Remus287/Hydrophone/Top_Sheet_Diagram.png

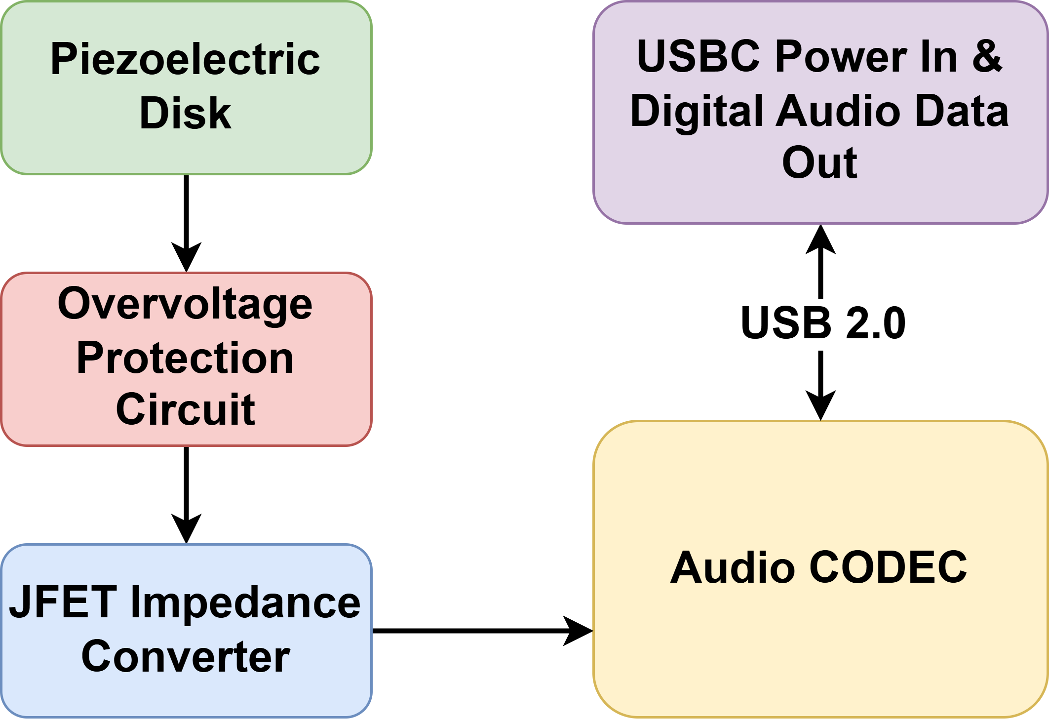
Top_Sheet_Diagram.png
