Remus287/Hydrophone/ul_OPA1642AIDR/D0008A.stp

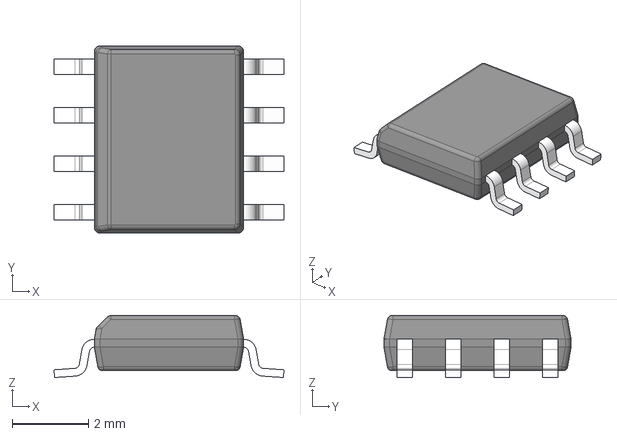
[picture p2: CAD file, 2025-02-16]
ul_OPA1642AIDR/D0008A.stp
6.02 x 4.90 x 1.63 mm
BODY-SO
LEAD-D0008A x 8
