Remus287/Hydrophone/ul_PCM2912APJTR/PJT0032A.stp

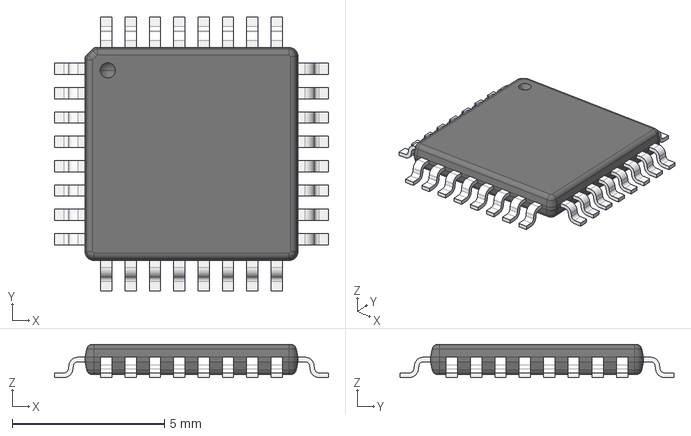
[picture p3: CAD file, 2025-02-16]
ul_PCM2912APJTR/PJT0032A.stp
9.00 x 9.00 x 1.10 mm
LEAD-QFP x 32
