Remus287/Hydrophone/Hydrophone.kicad_pcb

## KiCad design Hydrophone.kicad_pcb (2025-02-17)

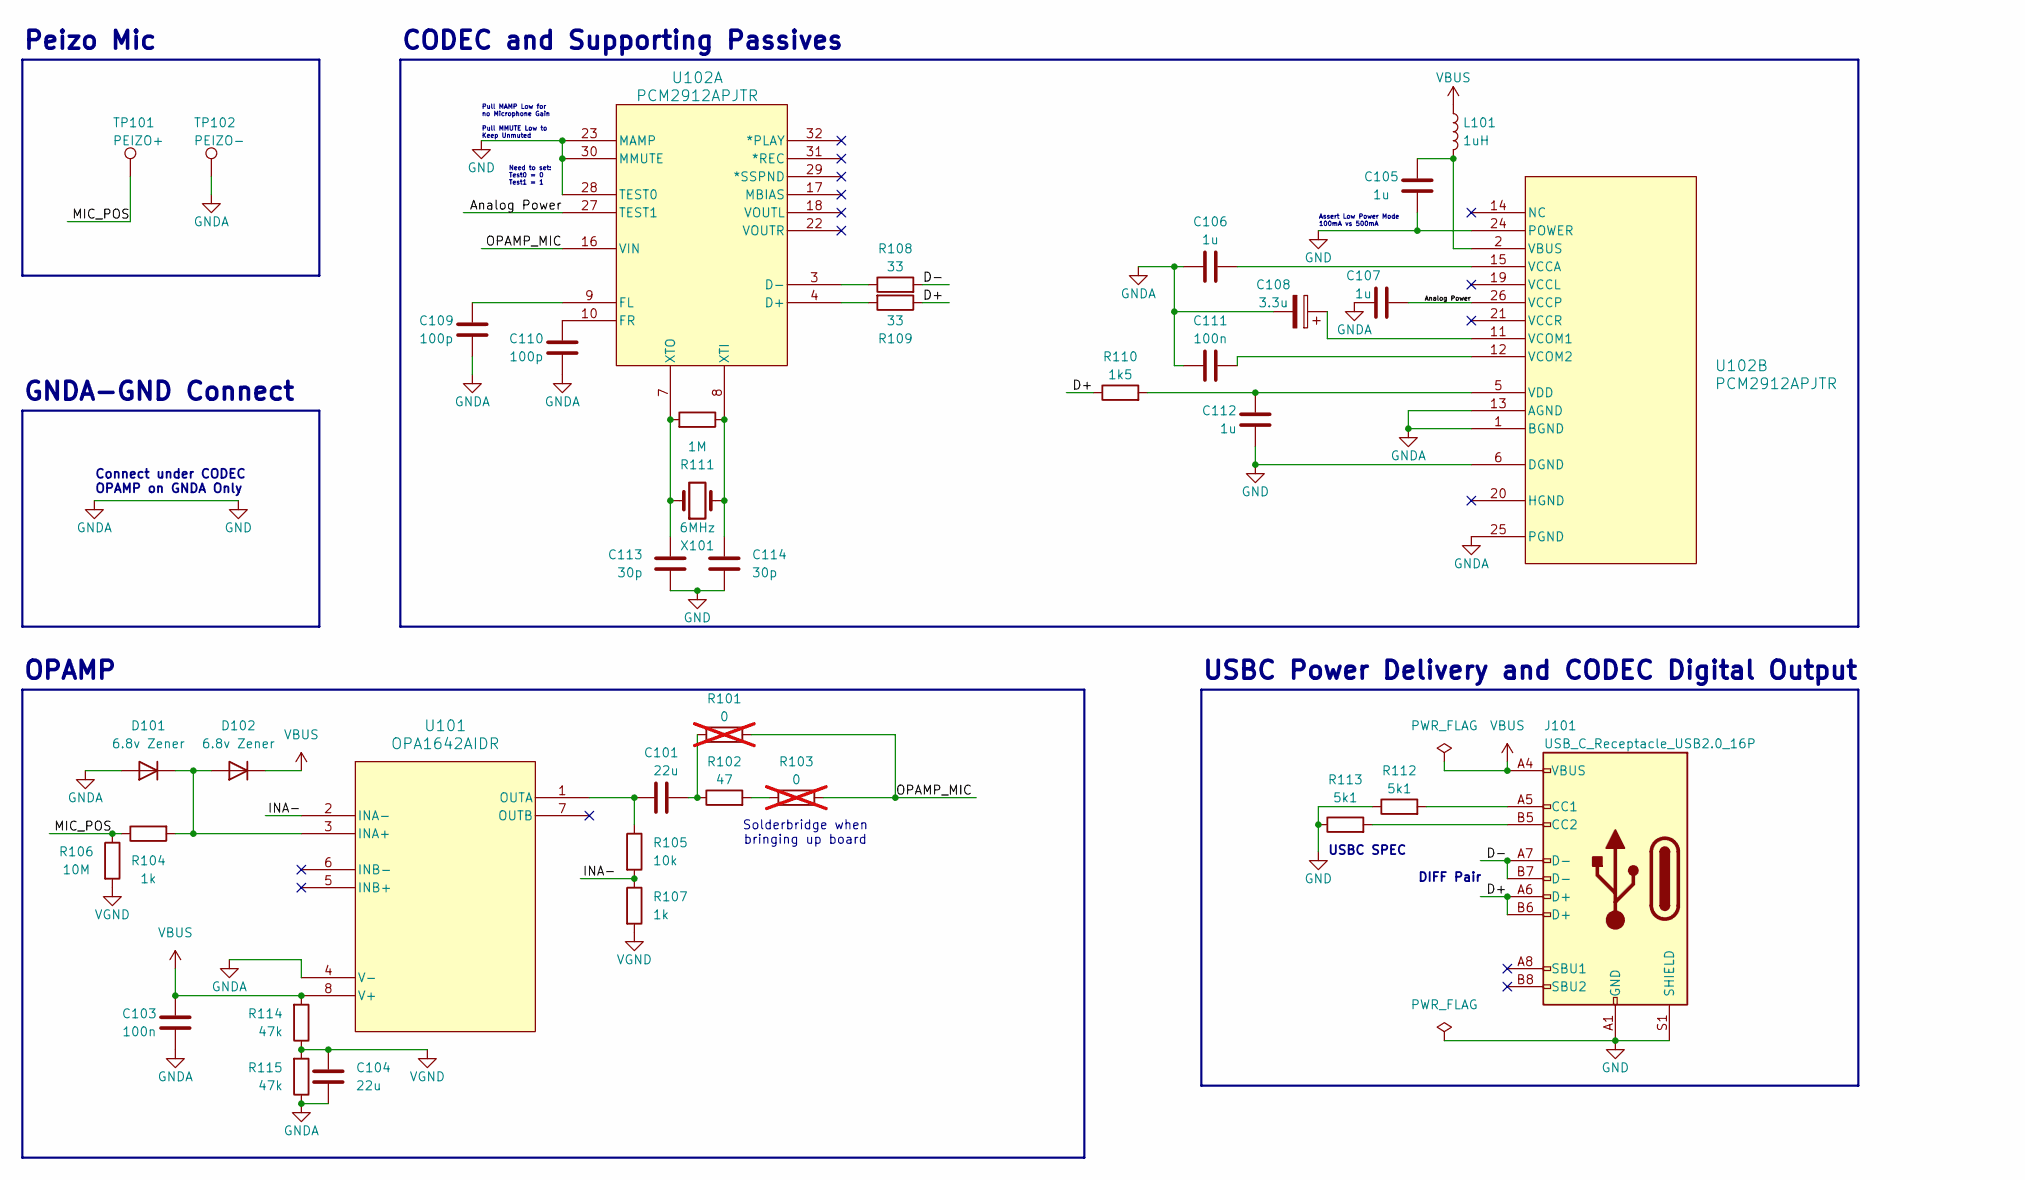
[picture p4: schematic USBC_Out.kicad_sch, Hydrophone]

Parts:
C101, C104: 22u; C_0805_2012Metric; Part Number CL21A226MAQNNNE; JLCPCB Part# C45783
C103, C111: 100n; C_0402_1005Metric; Part Number CL05B104KO5NNNC; JLCPCB Part# C1525
C105, C106, C107, C112: 1u; C_0402_1005Metric; Part Number CL05A105KA5NQNC; JLCPCB Part# C52923
C108: 3.3u; CP_EIA-3216-18_Kemet-A; Part Number TAJA335K016RNJ; JLCPCB Part# C7184
C109, C110: 100p; C_0402_1005Metric; Part Number 0402CG101J500NT; JLCPCB Part# C1546
C113, C114: 30p; C_0402_1005Metric; Part Number 0402CG300J500NT; JLCPCB Part# C1570
D101, D102: 6.8v Zener; D_SOD-123; Part Number BZT52C6V8; JLCPCB Part# C2120
J101: USB_C_Receptacle_USB2.0_16P; USB_C_Receptacle_G-Switch_GT-USB-7025; Part Number GT-USB-7025; JLCPCB Part# C963213
L101: 1uH; L_1210_3225Metric; Part Number NLV32T-1R0J-PF; JLCPCB Part# C22202
R101, R103: 0; R_0603_1608Metric; not fitted
R102: 47; R_0805_2012Metric; Part Number 1206W4F1002T5E; JLCPCB Part# C17902
R104, R107: 1k; C_0402_1005Metric; Part Number 0402WGF1001TCE; JLCPCB Part# C11702
R105: 10k; R_1206_3216Metric; Part Number 1206W4F1002T5E; JLCPCB Part# C17902
R106: 10M; R_0402_1005Metric; Part Number 0402WGF1005TCE; JLCPCB Part# C26082
R108, R109: 33; R_0402_1005Metric; Part Number 0402WGF330JTCE; JLCPCB Part# C25105
R110: 1k5; R_0402_1005Metric; Part Number 0402WGJ0152TCE; JLCPCB Part# C25930
R111: 1M; R_0402_1005Metric; Part Number 0402WGF1004TCE; JLCPCB Part# C26083
R112, R113: 5k1; R_0402_1005Metric; Part Number 0402WGF5101TCE; JLCPCB Part# C25905
R114, R115: 47k; R_0402_1005Metric; Part Number 0402WGF4702TCE; JLCPCB Part# C25792
TP101: PEIZO+; TestPoint_Pad_D1.0mm; Part Number ---
TP102: PEIZO-; TestPoint_Pad_D1.0mm; Part Number ---
U101: OPA1642AIDR; D8; Part Number OPA1642AIDR; JLCPCB Part# C67640
U102: PCM2912APJTR; PJT32; Part Number PCM2912APJTR; JLCPCB Part# C475497
X101: 6MHz; Crystal_SMD_HC49-SD; Part Number H6OEL89CSC-SUGYLC-6M; JLCPCB Part# C7528811

Connections:
/USBC_Out/Analog Power: C107.1, U102.26 (VCCP), U102.27 (TEST1)
/USBC_Out/D+: J101.A6 (D+), J101.B6 (D+), R109.1, R110.1
/USBC_Out/D-: J101.A7 (D-), J101.B7 (D-), R108.2
/USBC_Out/INA-: R105.2, R107.1, U101.2 (INA-)
/USBC_Out/MIC_POS: R104.1, R106.1, TP101.1
/USBC_Out/OPAMP_MIC: R101.2, R103.2, U102.16 (VIN)
GND: C103.2, C104.2, C105.2, C106.2, C107.2, C108.2, C109.2, C110.2, C111.2, C112.1, C113.2, C114.2, D101.2 (A), J101.A1 (GND), J101.A12 (GND), J101.B1 (GND), J101.B12 (GND), J101.S1 (SHIELD), R112.1, R113.1, R115.1, TP102.1, U101.4 (V-), U102.1 (BGND), U102.6 (DGND), U102.13 (AGND), U102.23 (MAMP), U102.24 (POWER), U102.25 (PGND), U102.28 (TEST0), U102.30 (MMUTE)
unnamed: C101.1, R101.1, R102.1
unnamed: D101.1 (K), D102.2 (A), R104.2, U101.3 (INA+)
unnamed: J101.A5 (CC1), R112.2
unnamed: J101.B5 (CC2), R113.2
unnamed: R102.2, R103.1
unnamed: C101.2, R105.1, U101.1 (OUTA)
unnamed: R109.2, U102.4 (D+)
unnamed: R108.1, U102.3 (D-)
unnamed: C109.1, U102.9 (FL)
unnamed: C110.1, U102.10 (FR)
unnamed: C114.1, R111.1, U102.8 (XTI), X101.2
unnamed: C113.1, R111.2, U102.7 (XTO), X101.1
unnamed: C105.1, L101.2, U102.2 (VBUS)
unnamed: C106.1, U102.15 (VCCA)
unnamed: C108.1, U102.11 (VCOM1)
unnamed: C111.1, U102.12 (VCOM2)
unnamed: C112.2, R110.2, U102.5 (VDD)
VBUS: C103.1, D102.1 (K), J101.A4 (VBUS), J101.A9 (VBUS), J101.B4 (VBUS), J101.B9 (VBUS), L101.1, R114.2, U101.8 (V+)
VGND: C104.1, R106.2, R107.2, R114.1, R115.2

Notes on the sheet:
DIFF Pair
Need to set: Test0 = 0 Test1 = 1
USBC Power Delivery and CODEC Digital Output
Assert Low Power Mode 100mA vs 500mA
USBC SPEC
CODEC and Supporting Passives
Connect under CODEC OPAMP on GNDA Only
Solderbridge when bringing up board
Peizo Mic
Pull MAMP Low for no Microphone Gain Pull MMUTE Low to Keep Unmuted
OPAMP
GNDA-GND Connect

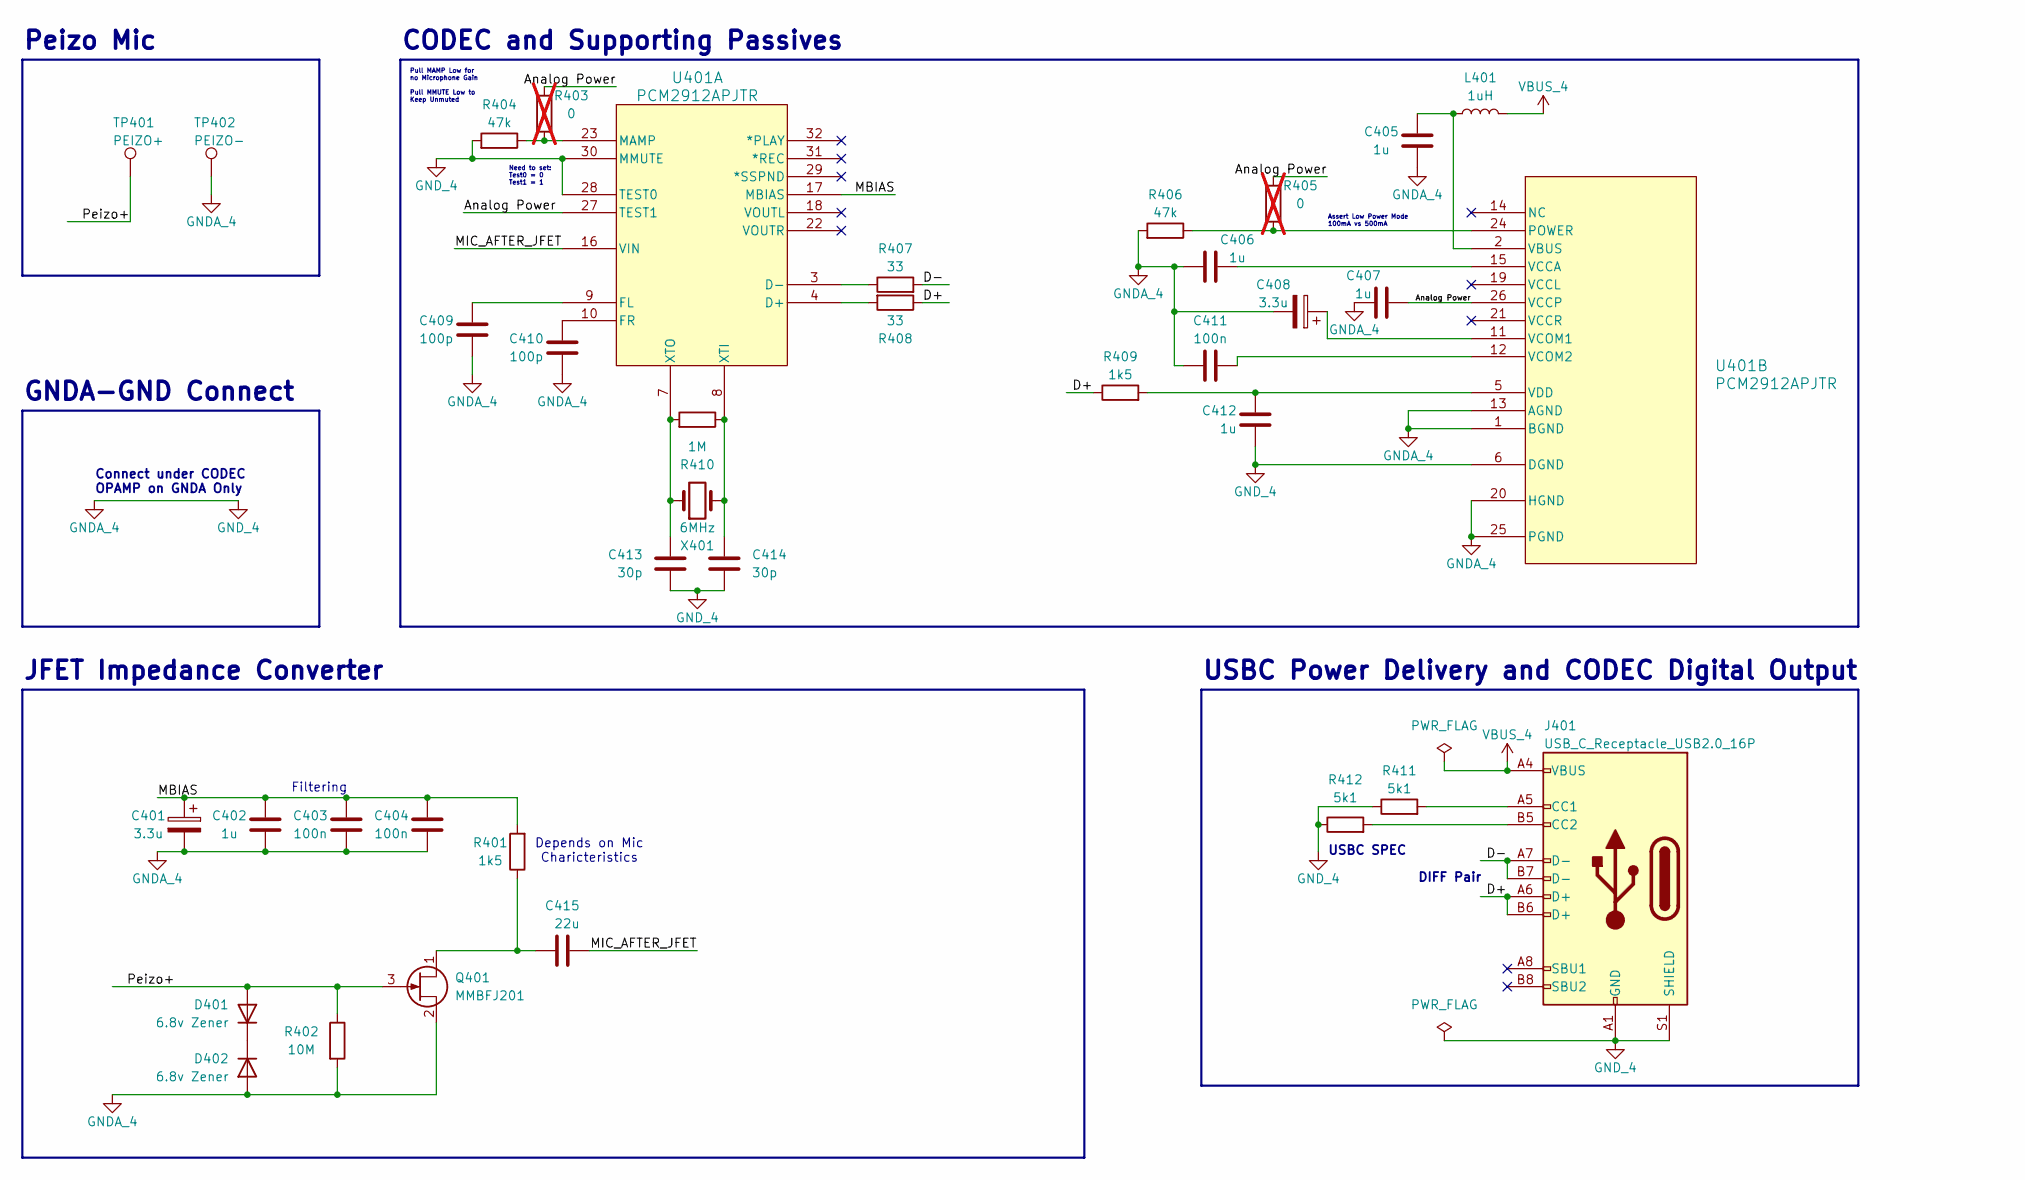
[picture p5: schematic USBC_Out_No_OPAMP.kicad_sch, Hydrophone]

Parts:
C401, C408: 3.3u; CP_EIA-3216-18_Kemet-A; Part Number TAJA335K016RNJ; JLCPCB Part# C7184
C402, C405, C406, C407, C412: 1u; C_0402_1005Metric; Part Number CL05A105KA5NQNC; JLCPCB Part# C52923
C403, C404, C411: 100n; C_0402_1005Metric; Part Number CL05B104KO5NNNC; JLCPCB Part# C1525
C409, C410: 100p; C_0402_1005Metric; Part Number 0402CG101J500NT; JLCPCB Part# C1546
C413, C414: 30p; C_0402_1005Metric; Part Number 0402CG300J500NT; JLCPCB Part# C1570
C415: 22u; C_0805_2012Metric; Part Number CL21A226MAQNNNE; JLCPCB Part# C45783
D401, D402: 6.8v Zener; D_SOD-123; Part Number BZT52C6V8; JLCPCB Part# C2120
J401: USB_C_Receptacle_USB2.0_16P; USB_C_Receptacle_G-Switch_GT-USB-7025; Part Number GT-USB-7025; JLCPCB Part# C963213
L401: 1uH; L_1210_3225Metric; Part Number NLV32T-1R0J-PF; JLCPCB Part# C22202
Q401: MMBFJ201; SOT-23; Part Number MMBFJ201; JLCPCB Part# C891687
R401, R409: 1k5; R_0402_1005Metric; Part Number 0402WGJ0152TCE; JLCPCB Part# C25930
R402: 10M; R_0402_1005Metric; Part Number 0402WGF1005TCE; JLCPCB Part# C26082
R403, R405: 0; R_0603_1608Metric; not fitted
R404, R406: 47k; R_0402_1005Metric; Part Number 0402WGF4702TCE; JLCPCB Part# C25792
R407, R408: 33; R_0402_1005Metric; Part Number 0402WGF330JTCE; JLCPCB Part# C25105
R410: 1M; R_0402_1005Metric; Part Number 0402WGF1004TCE; JLCPCB Part# C26083
R411, R412: 5k1; R_0402_1005Metric; Part Number 0402WGF5101TCE; JLCPCB Part# C25905
TP401: PEIZO+; TestPoint_Pad_D1.0mm; Part Number ---
TP402: PEIZO-; TestPoint_Pad_D1.0mm; Part Number ---
U401: PCM2912APJTR; PJT32; Part Number PCM2912APJTR; JLCPCB Part# C475497
X401: 6MHz; Crystal_SMD_HC49-SD; Part Number H6OEL89CSC-SUGYLC-6M; JLCPCB Part# C7528811

Connections:
/USBC_Out_No_OPAMP/Analog Power: C407.1, R403.2, R405.2, U401.26 (VCCP), U401.27 (TEST1)
/USBC_Out_No_OPAMP/D+: J401.A6 (D+), J401.B6 (D+), R408.1, R409.1
/USBC_Out_No_OPAMP/D-: J401.A7 (D-), J401.B7 (D-), R407.2
/USBC_Out_No_OPAMP/MBIAS: C401.1, C402.2, C403.2, C404.2, R401.2, U401.17 (MBIAS)
/USBC_Out_No_OPAMP/MIC_AFTER_JFET: C415.1, U401.16 (VIN)
/USBC_Out_No_OPAMP/Peizo+: D401.2 (A), Q401.3 (G), R402.1, TP401.1
GNDA_4: C401.2, C402.1, C403.1, C404.1, C405.2, C406.2, C407.2, C408.2, C409.2, C410.2, C411.2, C412.1, C413.2, C414.2, D402.2 (A), J401.A1 (GND), J401.A12 (GND), J401.B1 (GND), J401.B12 (GND), J401.S1 (SHIELD), Q401.2 (S), R402.2, R404.2, R406.2, R411.1, R412.1, TP402.1, U401.1 (BGND), U401.6 (DGND), U401.13 (AGND), U401.20 (HGND), U401.25 (PGND), U401.28 (TEST0), U401.30 (MMUTE)
unnamed: D401.1 (K), D402.1 (K)
unnamed: J401.A5 (CC1), R411.2
unnamed: J401.B5 (CC2), R412.2
unnamed: C415.2, Q401.1 (D), R401.1
unnamed: R408.2, U401.4 (D+)
unnamed: R407.1, U401.3 (D-)
unnamed: C409.1, U401.9 (FL)
unnamed: C410.1, U401.10 (FR)
unnamed: R403.1, R404.1, U401.23 (MAMP)
unnamed: C414.1, R410.1, U401.8 (XTI), X401.2
unnamed: C413.1, R410.2, U401.7 (XTO), X401.1
unnamed: R405.1, R406.1, U401.24 (POWER)
unnamed: C405.1, L401.2, U401.2 (VBUS)
unnamed: C406.1, U401.15 (VCCA)
unnamed: C408.1, U401.11 (VCOM1)
unnamed: C411.1, U401.12 (VCOM2)
unnamed: C412.2, R409.2, U401.5 (VDD)
VBUS_4: J401.A4 (VBUS), J401.A9 (VBUS), J401.B4 (VBUS), J401.B9 (VBUS), L401.1

Notes on the sheet:
Assert Low Power Mode 100mA vs 500mA
DIFF Pair
Peizo Mic
CODEC and Supporting Passives
JFET Impedance Converter
Need to set: Test0 = 0 Test1 = 1
USBC SPEC
GNDA-GND Connect
USBC Power Delivery and CODEC Digital Output
Filtering
Connect under CODEC OPAMP on GNDA Only
Depends on Mic Charicteristics
Pull MAMP Low for no Microphone Gain Pull MMUTE Low to Keep Unmuted

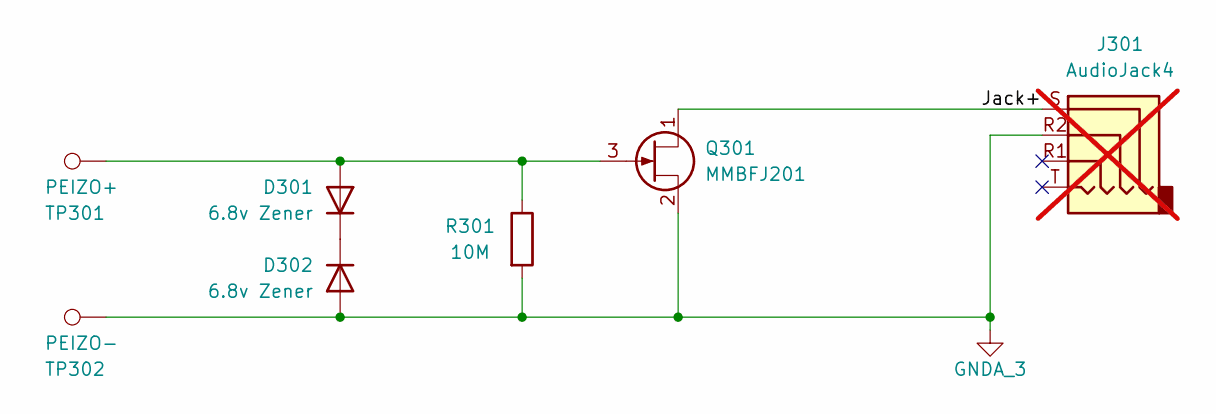
[picture p6: schematic FET_Impedance_Converter.kicad_sch, Hydrophone]

Parts:
D301, D302: 6.8v Zener; D_SOD-123; Part Number BZT52C6V8; JLCPCB Part# C2120
J301: AudioJack4; Jack_3.5mm_PJ320D_Horizontal; not fitted
Q301: MMBFJ201; SOT-23; Part Number MMBFJ201; JLCPCB Part# C891687
R301: 10M; R_0402_1005Metric; Part Number 0402WGF1005TCE; JLCPCB Part# C26082
TP301: PEIZO+; TestPoint_Pad_D1.0mm; Part Number ---
TP302: PEIZO-; TestPoint_Pad_D1.0mm; Part Number ---

Connections:
/FET_Impedance_Converter/Jack+: J301.S, Q301.1 (D)
GNDA_3: D302.2 (A), J301.R2, Q301.2 (S), R301.2, TP302.1
unnamed: D301.2 (A), Q301.3 (G), R301.1, TP301.1
unnamed: D301.1 (K), D302.1 (K)

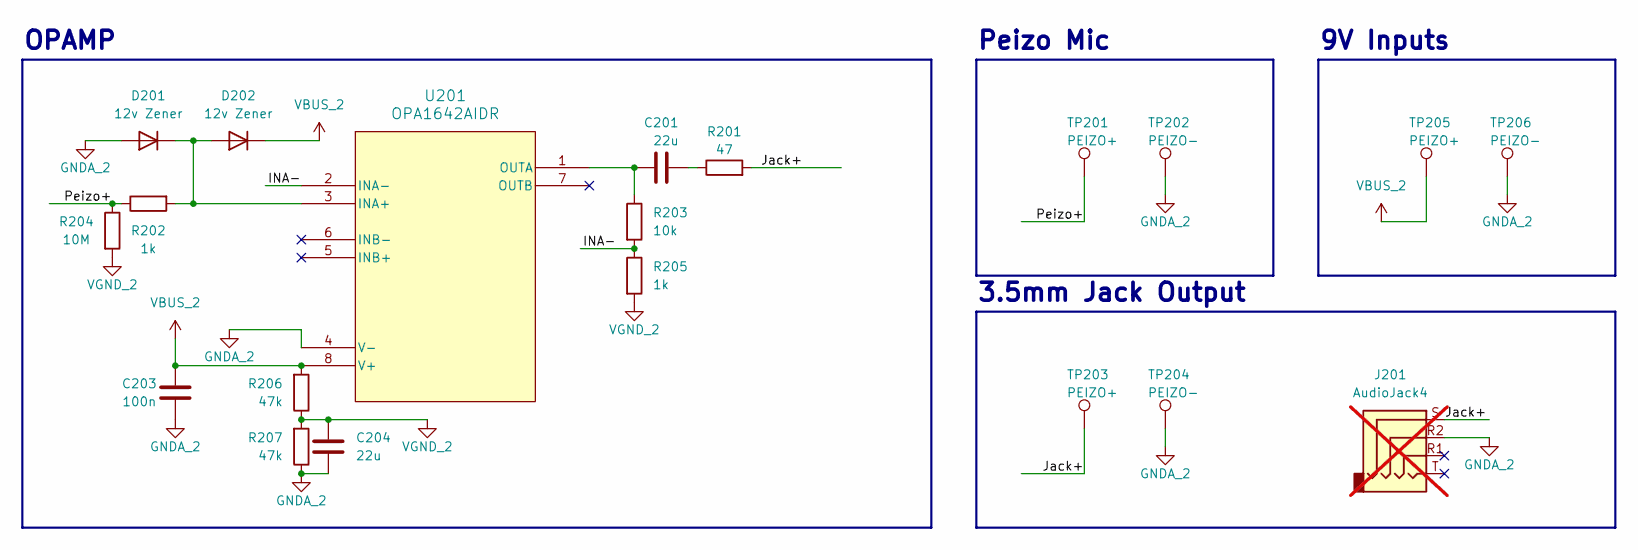
[picture p7: schematic 9V_To_3.5mm_Jack.kicad_sch, Hydrophone]

Parts:
C201, C204: 22u; C_0805_2012Metric; Part Number CL21A226MAQNNNE; JLCPCB Part# C45783
C203: 100n; C_0402_1005Metric; Part Number CL05B104KO5NNNC; JLCPCB Part# C1525
D201, D202: 12v Zener; D_SOD-123; Part Number BZT52C12; JLCPCB Part# C43491
J201: AudioJack4; Jack_3.5mm_PJ320D_Horizontal; not fitted
R201: 47; R_0805_2012Metric; Part Number 1206W4F1002T5E; JLCPCB Part# C17902
R202, R205: 1k; C_0402_1005Metric; Part Number 0402WGF1001TCE; JLCPCB Part# C11702
R203: 10k; R_1206_3216Metric; Part Number 1206W4F1002T5E; JLCPCB Part# C17902
R204: 10M; R_0402_1005Metric; Part Number 0402WGF1005TCE; JLCPCB Part# C26082
R206, R207: 47k; R_0402_1005Metric; Part Number 0402WGF4702TCE; JLCPCB Part# C25792
TP201, TP203, TP205: PEIZO+; TestPoint_Pad_D1.0mm; Part Number ---
TP202, TP204, TP206: PEIZO-; TestPoint_Pad_D1.0mm; Part Number ---
U201: OPA1642AIDR; D8; Part Number OPA1642AIDR; JLCPCB Part# C67640

Connections:
/9V_To_3.5mm_Jack/INA-: R203.2, R205.1, U201.2 (INA-)
/9V_To_3.5mm_Jack/Jack+: J201.S, R201.2, TP203.1
/9V_To_3.5mm_Jack/Peizo+: R202.1, R204.1, TP201.1
GNDA_2: C203.2, C204.2, D201.2 (A), J201.R2, R207.1, TP202.1, TP204.1, TP206.1, U201.4 (V-)
unnamed: C201.1, R201.1
unnamed: D201.1 (K), D202.2 (A), R202.2, U201.3 (INA+)
unnamed: C201.2, R203.1, U201.1 (OUTA)
VBUS_2: C203.1, D202.1 (K), R206.2, TP205.1, U201.8 (V+)
VGND_2: C204.1, R204.2, R205.2, R206.1, R207.2

Notes on the sheet:
Peizo Mic
OPAMP
3.5mm Jack Output
9V Inputs

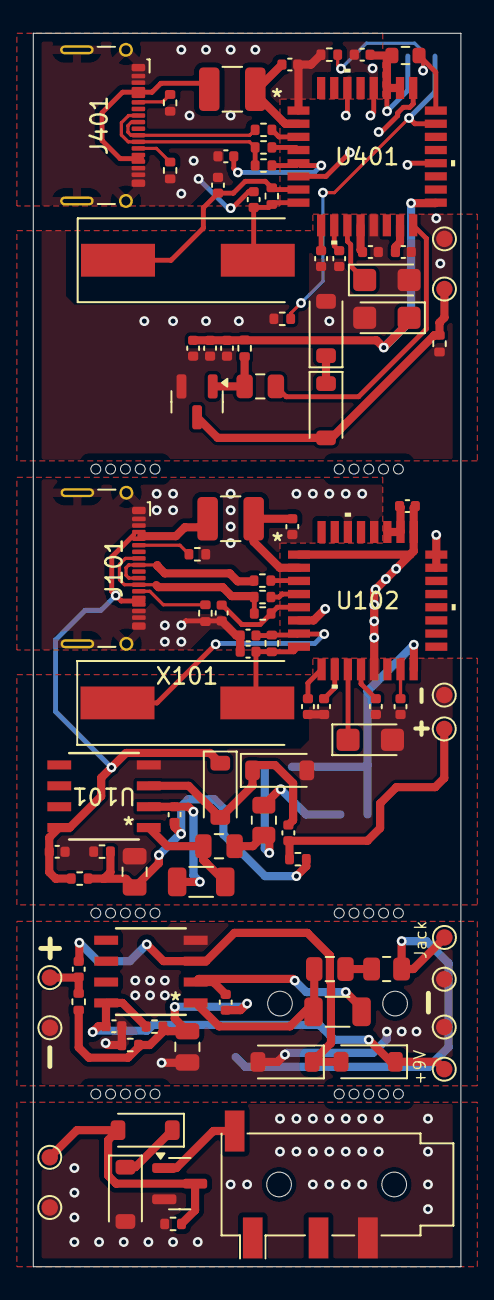
[picture p8: board Hydrophone.kicad_pcb from above]

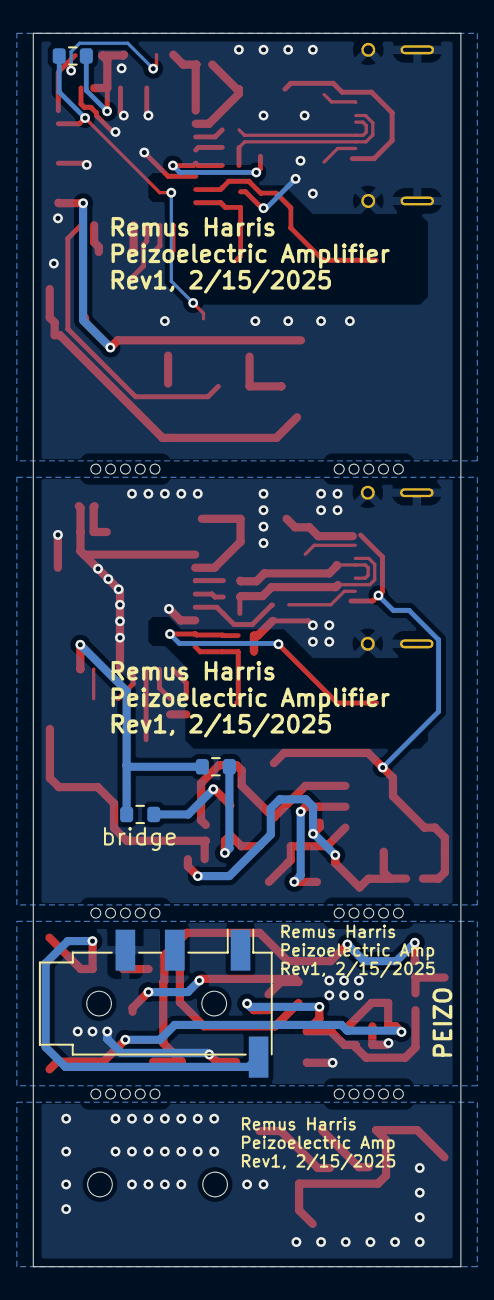
[picture p9: board Hydrophone.kicad_pcb from below]

Board: 2 copper layers, 26.0 x 75.0 mm, 100 parts (4 on the bottom side), 64 nets.
