Remus287/Hydrophone/(commit log)

2025-02-16 added dual channel op-amp lib file
    [D0008A.stp]
2025-02-16 added CODEC lib file
    [PJT0032A.stp]
2025-02-16 finished digital pcb version
    [Hydrophone.csv, Hydrophone.kicad_pcb, Hydrophone.kicad_sch, USBC_Out.kicad_sch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]
2025-02-17 repo as manufactured
    [9V_To_3.5mm_Jack.kicad_sch, FET_Impedance_Converter.kicad_sch, Hydrophone.csv, Hydrophone.kicad_pcb, Hydrophone.kicad_sch, USBC_Out.kicad_sch, USBC_Out_No_OPAMP.kicad_sch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]
2025-02-19 fixed BOM to correct part number for 47ohm 0805 resistor. New file sent to JLCPCB for manufacturing
    [9V_To_3.5mm_Jack.kicad_sch, Hydrophone.csv, USBC_Out.kicad_sch]
2025-03-07 added top sheet drawing to schematic
    [USBC_Out_No_OPAMP.kicad_sch]
